jnd-cz/kids-timer/production/bom.csv

Designator | Footprint | Quantity | Value | LCSC Part #
BZ1 | Buzzer_HNDZ_MLT-8530_8.5x8.5mm | 1 | MLT-8530 | C94599
C1 | 0805 | 1 | 4.7uF | C1779
C10, C11, C12, C13, C14, C15, C16, C17, C18, C19, C20, C30, C31, C32, C33, C36, C37, C38, C39, C41, C42, C50, C51, C61, C62, C64, C71 | 0402 | 27 | 100nF | C1525
C2, C3, C43, C5, C63, C7, C70, C8 | 0805 | 8 | 10uF | C15850
C21, C22, C23, C52 | 0402 | 4 | 4.7uF | C23733
C24, C25 | 0402 | 2 | 33pF | C1562
C34, C40, C44 | 0805 | 3 | 22uF | C45783
C4, C6, C9 | 0603 | 3 | 100nF | C14663
C60 | 0402 | 1 | 4.7nF | C1538
D1 | 0603 | 1 | CHG | C2286
D100, D101, D102, D103, D104, D105, D106, D107, D108, D109, D110, D111, D112, D113, D114, D115, D116, D117, D118, D119, D120, D121, D122, D123, D124, D125, D126, D127, D128, D129, D130, D131, D132, D133, D134, D135, D136, D137, D138, D139, D140, D141, D142, D143, D144, D145, D146, D147, D148, D149, D150, D151, D152, D153, D154, D155, D156, D157, D158, D159 | 0805 | 60 | GREEN | C2297
D160, D161, D162, D163 | 0805 | 4 | YELLOW | C2296
D200, D201, D202, D203, D204, D205, D206, D207, D208, D209, D210, D211, D212, D213, D214, D215, D216, D217, D218, D219, D220, D221, D222, D223, D224, D225, D226, D227, D228, D229, D230, D231, D232, D233, D234, D235, D236, D237, D238, D239, D240, D241, D242, D243, D244, D245, D246, D247, D248, D249, D250, D251, D252, D253, D254, D255, D256, D257, D258, D259 | 0805 | 60 | RED | C84256
D300, D301 | 0805 | 2 | WHITE | C34499
DS1, DS2, DS3, DS4 | GS8011_SMD_16.8x28mm | 4 | GS8011AW-G | C22462707
J1 | USB_C_Receptacle_HRO_TYPE-C-31-M-12 | 1 | USB-C | C165948
J2 | JST_PH_S2B-PH-SM4-TB_1x02-1MP_P2.00mm_Horizontal | 1 | LiPo JST-PH | C295747
J4 | JST_PH_S2B-PH-SM4-TB_1x02-1MP_P2.00mm_Horizontal | 1 | SPEAKER | C295747
L1 | 1008 | 1 | 1.5uH | C98349
L2 | L_Changjiang_FTC201612S | 1 | 3.3uH | C41405891
Q1, Q4 | SOT-23 | 2 | AO3401A | C15127
Q2 | SOT-23-6 | 1 | HJ8205 | C20069150
Q3, Q5 | SOT-23 | 2 | 2N7002 | C8545
R1, R2 | 0603 | 2 | 5.1k | C23186
R10, R6, R7, R8 | 0603 | 4 | 100k | C25803
R11 | 0603 | 1 | 100 | C22775
R12, R3 | 0603 | 2 | 1k | C21190
R13 | 0603 | 1 | 1M | C22935
R14, R15 | 0603 | 2 | 220k | C22961
R16, R22, R73 | 0402 | 3 | 33 | C25105
R17, R20 | 0402 | 2 | 1k | C11702
R18, R19 | 0603 | 2 | 27 | C25190
R21, R50, R72 | 0402 | 3 | 10k | C25744
R30, R31, R32, R33, R34, R35, R36, R37 | 0402 | 8 | 3.3k | C25890
R38, R39 | 0402 | 2 | 2k | C4109
R4 | 0603 | 1 | 1.2k | C22765
R40, R41, R63, R70 | 0402 | 4 | 100k | C25741
R5 | 0603 | 1 | 10k | C25804
R51, R52, R60 | 0402 | 3 | 4.7k | C25900
R53, R54 | 0402 | 2 | 1M | C26083
R61, R62 | 0402 | 2 | 47k | C25792
R71 | 0402 | 1 | 470 | C25117
R9 | 0603 | 1 | 1.5k | C22843
SW1 | SW_SPDT_MSK12C02_EdgeNotch | 1 | MSK12C02 | C22435661
SW2 | SW_SPST_XUNPU_TS-1088_3.9x3mm | 1 | BOOTSEL | C720477
SW3 | SW_SPST_XUNPU_TS-1088_3.9x3mm | 1 | RESET | C720477
SW4 | SW_SPST_XUNPU_TS-1088_3.9x3mm | 1 | BTN1 | C720477
SW5 | SW_SPST_XUNPU_TS-1088_3.9x3mm | 1 | BTN2 | C720477
SW6 | SW_SPST_XUNPU_TS-1088_3.9x3mm | 1 | BTN3 | C720477
SW7 | SW_SPST_XUNPU_TS-1088_3.9x3mm | 1 | BTN4 | C720477
SW8 | SW_SPST_XUNPU_TS-1088_3.9x3mm | 1 | BTN5 | C720477
U1 | SOT-23-6 | 1 | SRV05-4 | C85364
U10, U11, U12, U13, U14, U15, U16, U17, U18, U19 | QSOP-24_3.9x8.7mm_P0.635mm | 10 | SM16206S | C121618
U2 | VQFN-16-1EP_3x3mm_P0.5mm_EP1.6x1.6mm | 1 | BQ24073RGT | C15220
U3 | SOT-23-6 | 1 | DW01A | C42380662
U4 | WSON-10-1EP_2.5x2.5mm_P0.5mm_EP1.2x2mm | 1 | TPS63031DSK | C15516
U5 | QFN-60-1EP_7x7mm_P0.4mm_EP3.4x3.4mm | 1 | RP2354A | C41378174
U6 | Vishay_VEML6030_2x2mm | 1 | VEML6030 | C132182
U7 | LGA-12_2x2mm_P0.5mm | 1 | STK8328-C | C49230199
U8 | RaspberryPi_RM2_14.5x16.5mm | 1 | RMC20452T | C49451547
U9 | MSOP-8_3x3mm_P0.65mm | 1 | PAM8302AAS | C113367
Y1 | Crystal_SMD_3225-4Pin_3.2x2.5mm | 1 | 12MHz 20pF | C9002
