jnd-cz/kids-timer/kids-timer.kicad_pcb

## KiCad design kids-timer.kicad_pcb (2026-10-30)

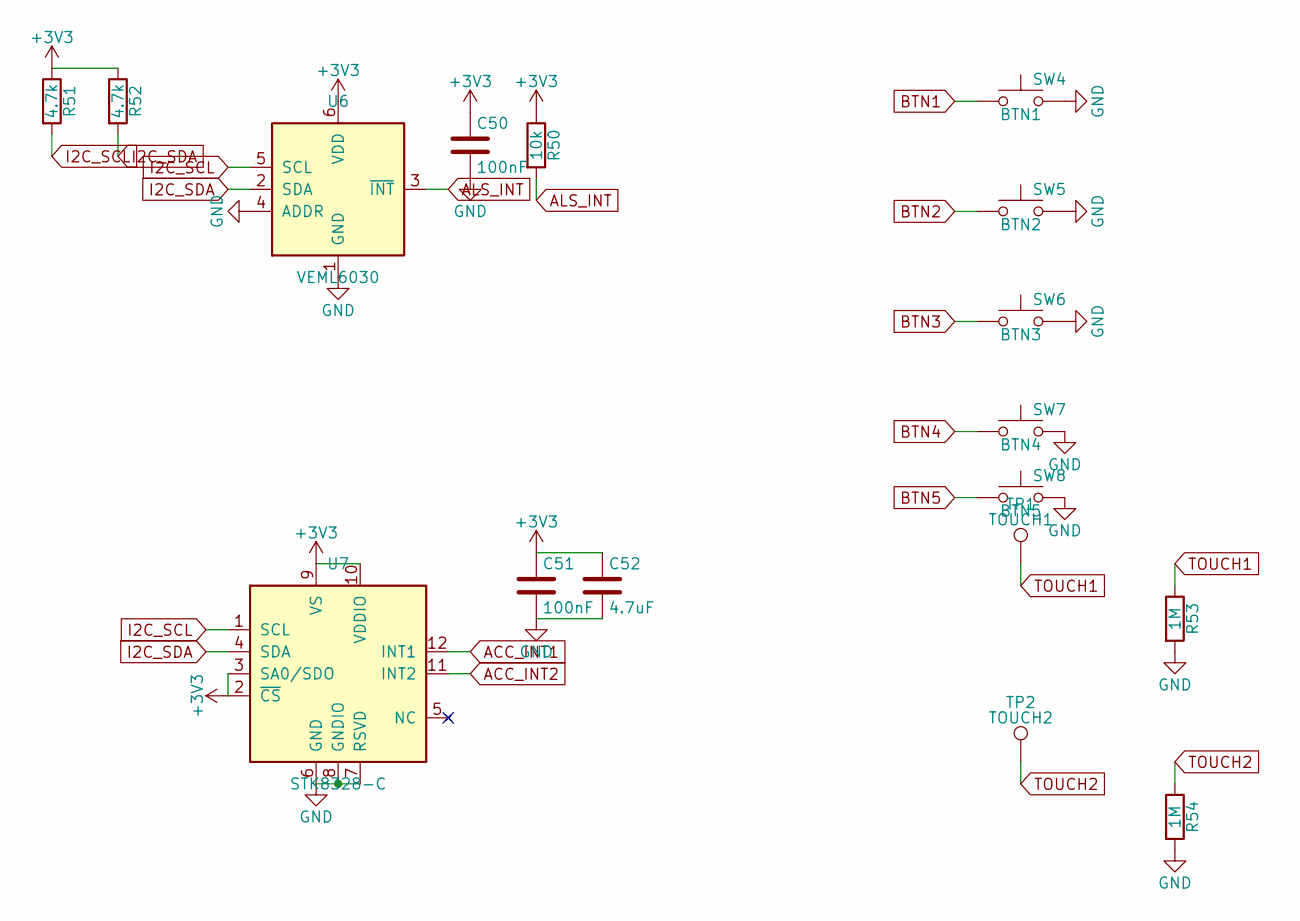
[picture p1: schematic sensors.kicad_sch]

Parts:
C50, C51: 100nF; C_0402_1005Metric; LCSC C1525
C52: 4.7uF; C_0402_1005Metric; LCSC C23733
R50: 10k; R_0402_1005Metric; LCSC C25744
R51, R52: 4.7k; R_0402_1005Metric; LCSC C25900
R53, R54: 1M; R_0402_1005Metric; LCSC C26083
SW4: BTN1; SW_SPST_XUNPU_TS-1088_3.9x3mm; MPN TS-1088-AR02016; LCSC C720477
SW5: BTN2; SW_SPST_XUNPU_TS-1088_3.9x3mm; MPN TS-1088-AR02016; LCSC C720477
SW6: BTN3; SW_SPST_XUNPU_TS-1088_3.9x3mm; MPN TS-1088-AR02016; LCSC C720477
SW7: BTN4; SW_SPST_XUNPU_TS-1088_3.9x3mm; MPN TS-1088-AR02016; LCSC C720477
SW8: BTN5; SW_SPST_XUNPU_TS-1088_3.9x3mm; MPN TS-1088-AR02016; LCSC C720477
TP1: TOUCH1; TouchPad_D12mm
TP2: TOUCH2; TouchPad_D12mm
U6: VEML6030; Vishay_VEML6030_2x2mm; MPN VEML6030; LCSC C132182
U7: STK8328-C; LGA-12_2x2mm_P0.5mm; MPN STK8328-C; LCSC C49230199

Connections:
+3V3: C50.1, C51.1, C52.1, R50.1, R51.1, R52.1, U6.6 (VDD), U7.2 (~CS), U7.3 (SA0/SDO), U7.9 (VS), U7.10 (VDDIO); also elsewhere on the board
ACC_INT1: U7.12 (INT1); also elsewhere on the board
ACC_INT2: U7.11 (INT2); also elsewhere on the board
ALS_INT: R50.2, U6.3 (~INT); also elsewhere on the board
BTN1: SW4.1; also elsewhere on the board
BTN2: SW5.1; also elsewhere on the board
BTN3: SW6.1; also elsewhere on the board
BTN4: SW7.1; also elsewhere on the board
BTN5: SW8.1; also elsewhere on the board
I2C_SCL: R51.2, U6.5 (SCL), U7.1 (SCL); also elsewhere on the board
I2C_SDA: R52.2, U6.2 (SDA), U7.4 (SDA); also elsewhere on the board
TOUCH1: R53.1, TP1.1 (1_1); also elsewhere on the board
TOUCH2: R54.1, TP2.1 (1_1); also elsewhere on the board

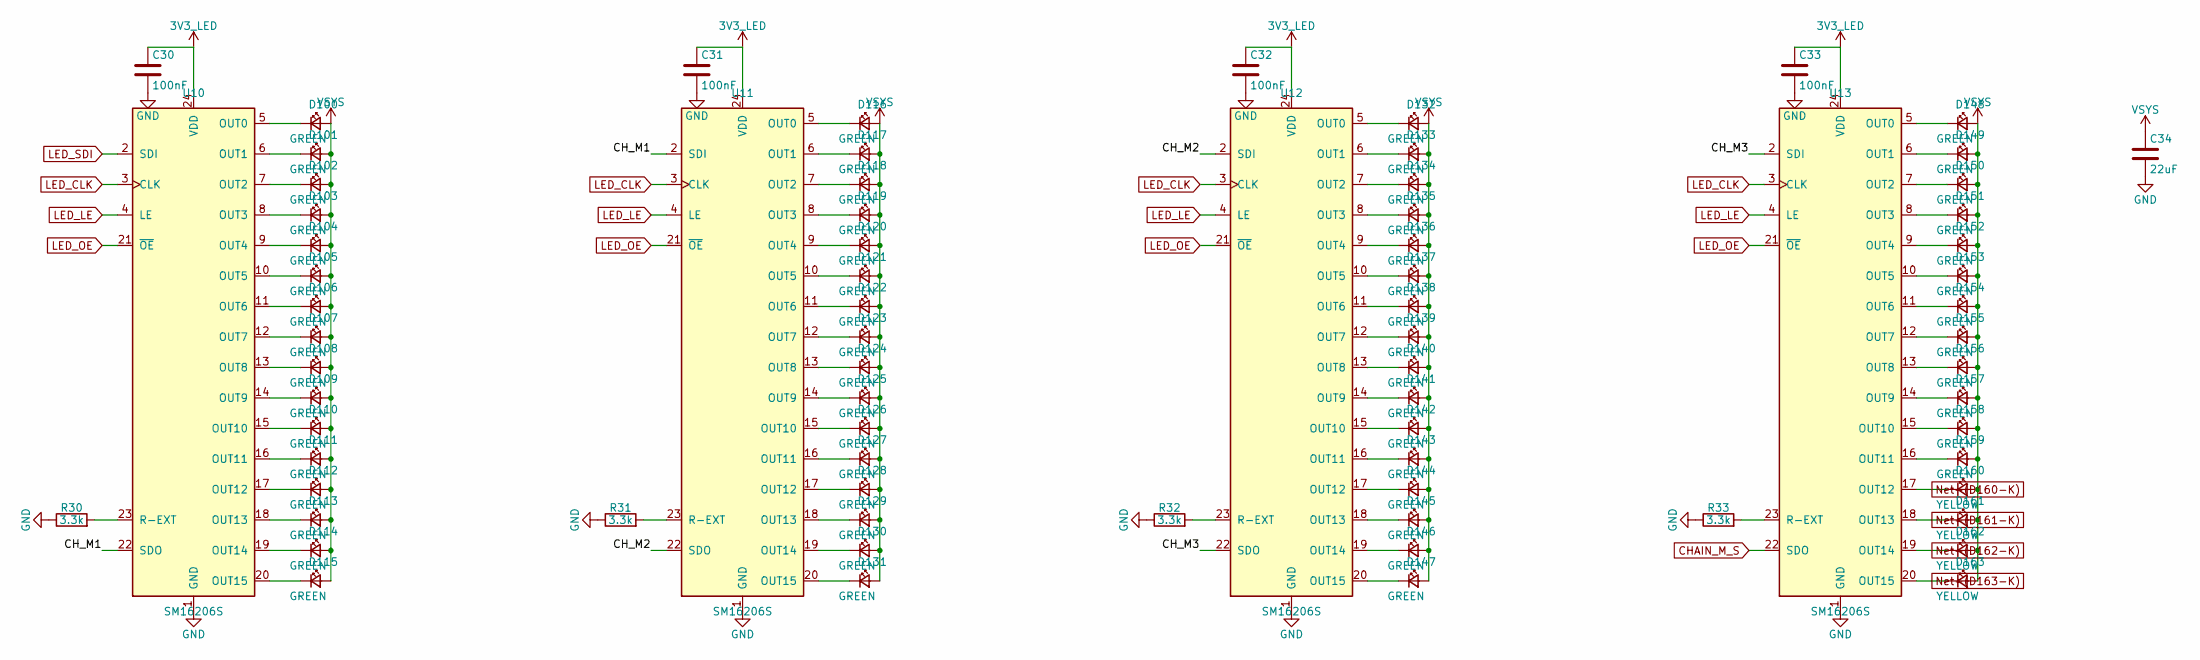
[picture p2: schematic minutes.kicad_sch]

Parts:
C30, C31, C32, C33: 100nF; C_0402_1005Metric; LCSC C1525
C34: 22uF; C_0805_2012Metric; LCSC C45783
D100, D101, D102, D103, D104, D105, D106, D107, D108, D109, D110, D111, D112, D113, D114, D115, D116, D117, D118, D119, D120, D121, D122, D123, D124, D125, D126, D127, D128, D129, D130, D131, D132, D133, D134, D135, D136, D137, D138, D139, D140, D141, D142, D143, D144, D145, D146, D147, D148, D149, D150, D151, D152, D153, D154, D155, D156, D157, D158, D159: GREEN; LED_0805_2012Metric_Ring; MPN KT-0805G; LCSC C2297
D160, D161, D162, D163: YELLOW; LED_0805_2012Metric; MPN KT-0805Y; LCSC C2296
R30, R31, R32, R33: 3.3k; R_0402_1005Metric; LCSC C25890
U10, U11, U12, U13: SM16206S; QSOP-24_3.9x8.7mm_P0.635mm; MPN SM16206S; LCSC C121618

Connections:
3V3_LED: C30.1, C31.1, C32.1, C33.1, U10.24 (VDD), U11.24 (VDD), U12.24 (VDD), U13.24 (VDD); also elsewhere on the board
/Minutes ring/CH_M1: U10.22 (SDO), U11.2 (SDI)
/Minutes ring/CH_M2: U11.22 (SDO), U12.2 (SDI)
/Minutes ring/CH_M3: U12.22 (SDO), U13.2 (SDI)
CHAIN_M_S: U13.22 (SDO); also elsewhere on the board
LED_CLK: U10.3 (CLK), U11.3 (CLK), U12.3 (CLK), U13.3 (CLK); also elsewhere on the board
LED_LE: U10.4 (LE), U11.4 (LE), U12.4 (LE), U13.4 (LE); also elsewhere on the board
LED_OE: U10.21 (~OE), U11.21 (~OE), U12.21 (~OE), U13.21 (~OE); also elsewhere on the board
LED_SDI: U10.2 (SDI); also elsewhere on the board
unnamed: D100.1 (K), U10.5 (OUT0)
unnamed: D101.1 (K), U10.6 (OUT1)
unnamed: D102.1 (K), U10.7 (OUT2)
unnamed: D103.1 (K), U10.8 (OUT3)
unnamed: D104.1 (K), U10.9 (OUT4)
unnamed: D105.1 (K), U10.10 (OUT5)
unnamed: D106.1 (K), U10.11 (OUT6)
unnamed: D107.1 (K), U10.12 (OUT7)
unnamed: D108.1 (K), U10.13 (OUT8)
unnamed: D109.1 (K), U10.14 (OUT9)
unnamed: D110.1 (K), U10.15 (OUT10)
unnamed: D111.1 (K), U10.16 (OUT11)
unnamed: D112.1 (K), U10.17 (OUT12)
unnamed: D113.1 (K), U10.18 (OUT13)
unnamed: D114.1 (K), U10.19 (OUT14)
unnamed: D115.1 (K), U10.20 (OUT15)
unnamed: D116.1 (K), U11.5 (OUT0)
unnamed: D117.1 (K), U11.6 (OUT1)
unnamed: D118.1 (K), U11.7 (OUT2)
unnamed: D119.1 (K), U11.8 (OUT3)
unnamed: D120.1 (K), U11.9 (OUT4)
unnamed: D121.1 (K), U11.10 (OUT5)
unnamed: D122.1 (K), U11.11 (OUT6)
unnamed: D123.1 (K), U11.12 (OUT7)
unnamed: D124.1 (K), U11.13 (OUT8)
unnamed: D125.1 (K), U11.14 (OUT9)
unnamed: D126.1 (K), U11.15 (OUT10)
unnamed: D127.1 (K), U11.16 (OUT11)
unnamed: D128.1 (K), U11.17 (OUT12)
unnamed: D129.1 (K), U11.18 (OUT13)
unnamed: D130.1 (K), U11.19 (OUT14)
unnamed: D131.1 (K), U11.20 (OUT15)
unnamed: D132.1 (K), U12.5 (OUT0)
unnamed: D133.1 (K), U12.6 (OUT1)
unnamed: D134.1 (K), U12.7 (OUT2)
unnamed: D135.1 (K), U12.8 (OUT3)
unnamed: D136.1 (K), U12.9 (OUT4)
unnamed: D137.1 (K), U12.10 (OUT5)
unnamed: D138.1 (K), U12.11 (OUT6)
unnamed: D139.1 (K), U12.12 (OUT7)
unnamed: D140.1 (K), U12.13 (OUT8)
unnamed: D141.1 (K), U12.14 (OUT9)
unnamed: D142.1 (K), U12.15 (OUT10)
unnamed: D143.1 (K), U12.16 (OUT11)
unnamed: D144.1 (K), U12.17 (OUT12)
unnamed: D145.1 (K), U12.18 (OUT13)
unnamed: D146.1 (K), U12.19 (OUT14)
unnamed: D147.1 (K), U12.20 (OUT15)
unnamed: D148.1 (K), U13.5 (OUT0)
unnamed: D149.1 (K), U13.6 (OUT1)
unnamed: D150.1 (K), U13.7 (OUT2)
unnamed: D151.1 (K), U13.8 (OUT3)
unnamed: D152.1 (K), U13.9 (OUT4)
unnamed: D153.1 (K), U13.10 (OUT5)
unnamed: D154.1 (K), U13.11 (OUT6)
unnamed: D155.1 (K), U13.12 (OUT7)
unnamed: D156.1 (K), U13.13 (OUT8)
unnamed: D157.1 (K), U13.14 (OUT9)
unnamed: D158.1 (K), U13.15 (OUT10)
unnamed: D159.1 (K), U13.16 (OUT11)
unnamed: D160.1 (K), U13.17 (OUT12)
unnamed: D161.1 (K), U13.18 (OUT13)
unnamed: D162.1 (K), U13.19 (OUT14)
unnamed: D163.1 (K), U13.20 (OUT15)
unnamed: R30.2, U10.23 (R-EXT)
unnamed: R31.2, U11.23 (R-EXT)
unnamed: R32.2, U12.23 (R-EXT)
unnamed: R33.2, U13.23 (R-EXT)
VSYS: C34.1, D100.2 (A), D101.2 (A), D102.2 (A), D103.2 (A), D104.2 (A), D105.2 (A), D106.2 (A), D107.2 (A), D108.2 (A), D109.2 (A), D110.2 (A), D111.2 (A), D112.2 (A), D113.2 (A), D114.2 (A), D115.2 (A), D116.2 (A), D117.2 (A), D118.2 (A), D119.2 (A), D120.2 (A), D121.2 (A), D122.2 (A), D123.2 (A), D124.2 (A), D125.2 (A), D126.2 (A), D127.2 (A), D128.2 (A), D129.2 (A), D130.2 (A), D131.2 (A), D132.2 (A), D133.2 (A), D134.2 (A), D135.2 (A), D136.2 (A), D137.2 (A), D138.2 (A), D139.2 (A), D140.2 (A), D141.2 (A), D142.2 (A), D143.2 (A), D144.2 (A), D145.2 (A), D146.2 (A), D147.2 (A), D148.2 (A), D149.2 (A), D150.2 (A), D151.2 (A), D152.2 (A), D153.2 (A), D154.2 (A), D155.2 (A), D156.2 (A), D157.2 (A), D158.2 (A), D159.2 (A), D160.2 (A), D161.2 (A), D162.2 (A), D163.2 (A); also elsewhere on the board

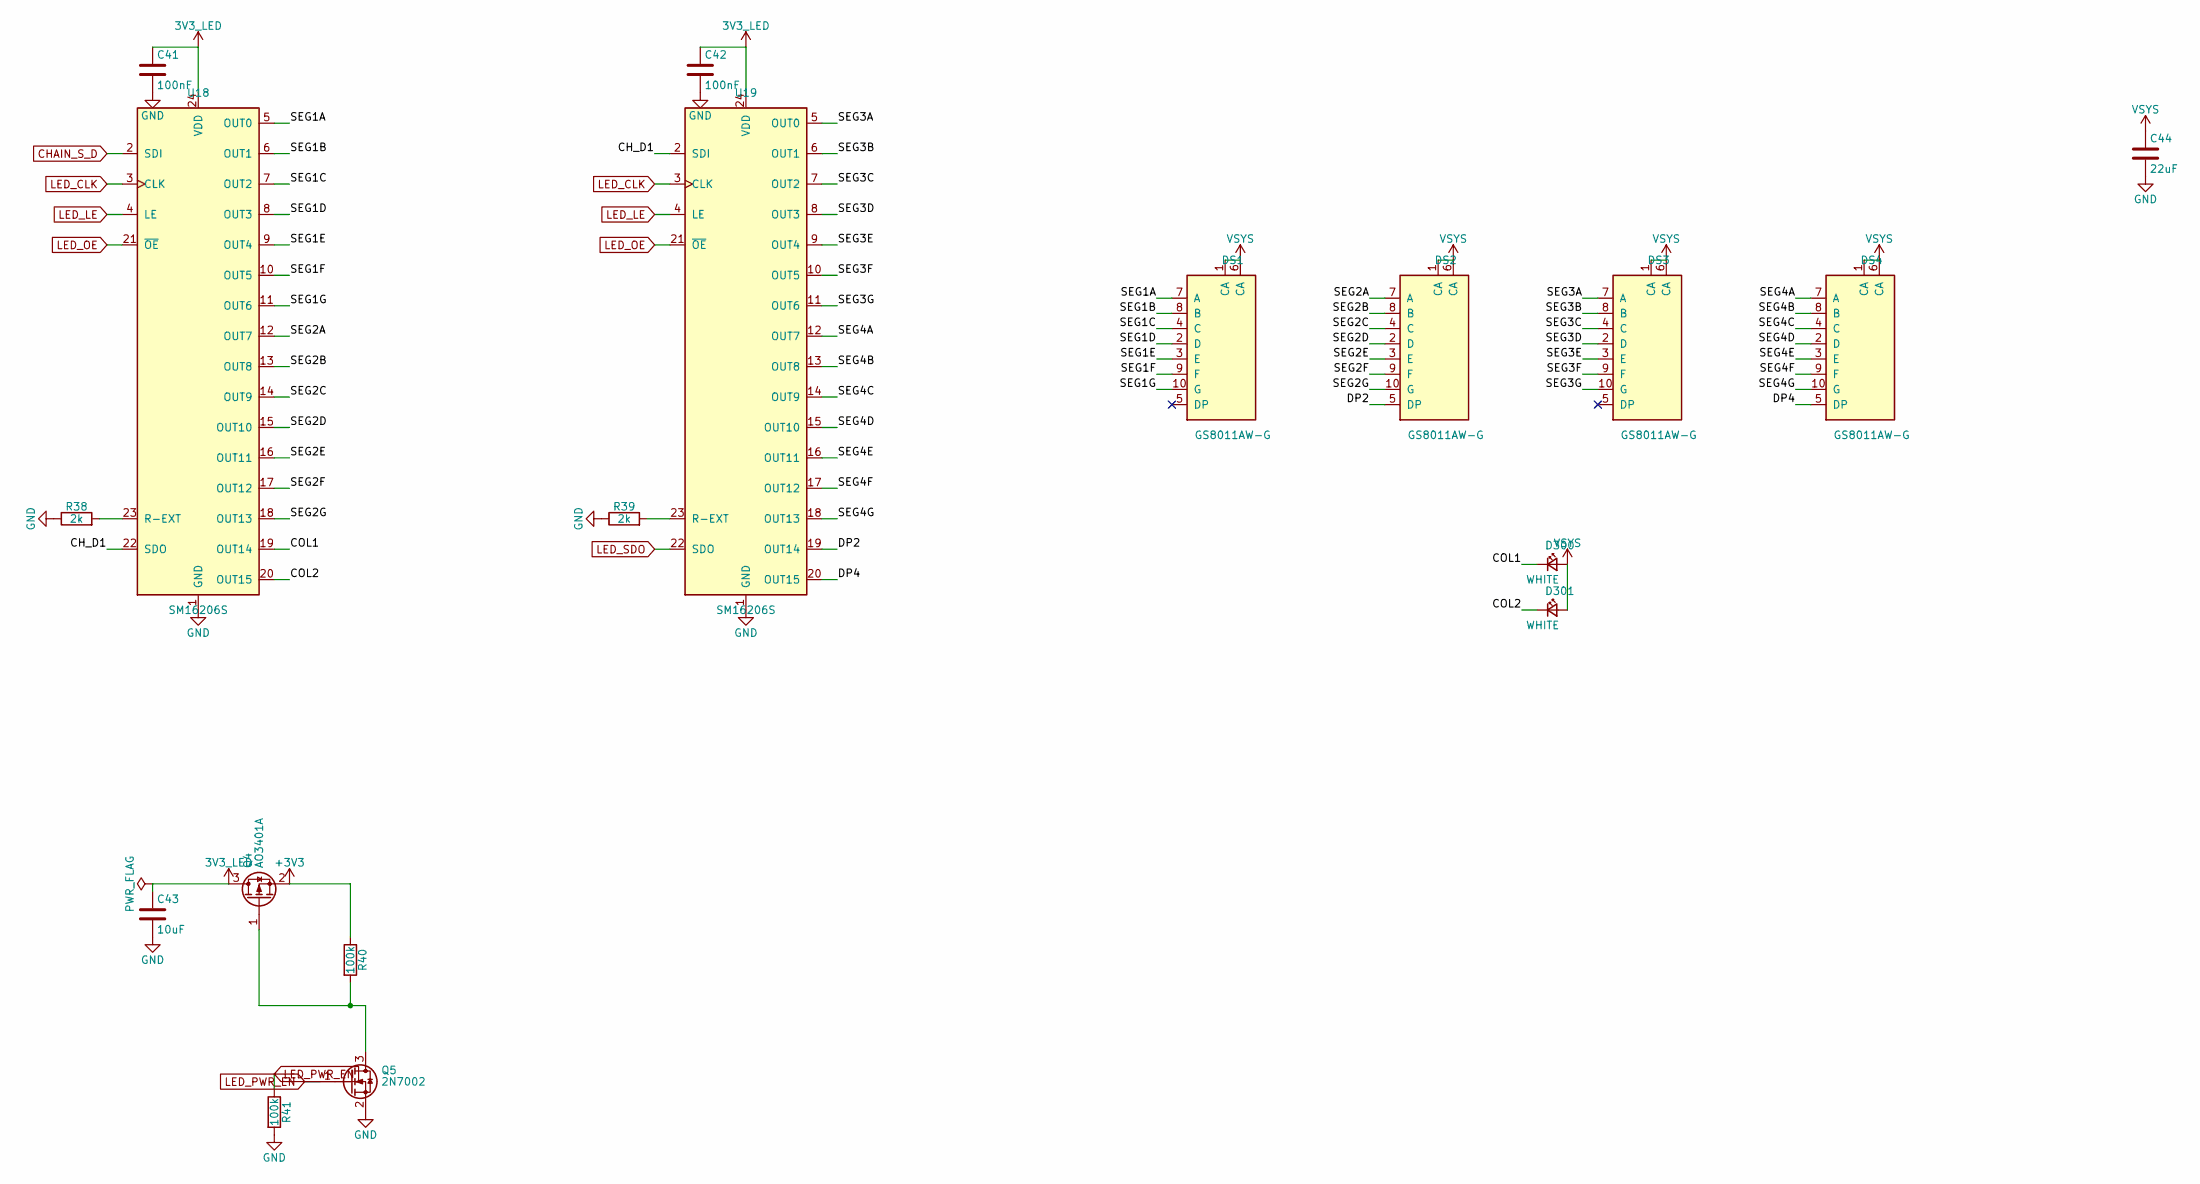
[picture p3: schematic display.kicad_sch]

Parts:
C41, C42: 100nF; C_0402_1005Metric; LCSC C1525
C43: 10uF; C_0805_2012Metric; LCSC C15850
C44: 22uF; C_0805_2012Metric; LCSC C45783
D300, D301: WHITE; LED_0805_2012Metric; LCSC C34499
DS1, DS2, DS3, DS4: GS8011AW-G; GS8011_SMD_16.8x28mm; LCSC C22462707
Q4: AO3401A; SOT-23; LCSC C15127
Q5: 2N7002; SOT-23; LCSC C8545
R38, R39: 2k; R_0402_1005Metric; LCSC C4109
R40, R41: 100k; R_0402_1005Metric; LCSC C25741
U18, U19: SM16206S; QSOP-24_3.9x8.7mm_P0.635mm; LCSC C121618

Connections:
3V3_LED: C41.1, C42.1, C43.1, Q4.3 (D), U18.24 (VDD), U19.24 (VDD); also elsewhere on the board
+3V3: Q4.2 (S), R40.1; also elsewhere on the board
/Display/CH_D1: U18.22 (SDO), U19.2 (SDI)
/Display/COL1: D300.1 (K), U18.19 (OUT14)
/Display/COL2: D301.1 (K), U18.20 (OUT15)
/Display/DP2: DS2.5 (DP), U19.19 (OUT14)
/Display/DP4: DS4.5 (DP), U19.20 (OUT15)
/Display/SEG1A: DS1.7 (A), U18.5 (OUT0)
/Display/SEG1B: DS1.8 (B), U18.6 (OUT1)
/Display/SEG1C: DS1.4 (C), U18.7 (OUT2)
/Display/SEG1D: DS1.2 (D), U18.8 (OUT3)
/Display/SEG1E: DS1.3 (E), U18.9 (OUT4)
/Display/SEG1F: DS1.9 (F), U18.10 (OUT5)
/Display/SEG1G: DS1.10 (G), U18.11 (OUT6)
/Display/SEG2A: DS2.7 (A), U18.12 (OUT7)
/Display/SEG2B: DS2.8 (B), U18.13 (OUT8)
/Display/SEG2C: DS2.4 (C), U18.14 (OUT9)
/Display/SEG2D: DS2.2 (D), U18.15 (OUT10)
/Display/SEG2E: DS2.3 (E), U18.16 (OUT11)
/Display/SEG2F: DS2.9 (F), U18.17 (OUT12)
/Display/SEG2G: DS2.10 (G), U18.18 (OUT13)
/Display/SEG3A: DS3.7 (A), U19.5 (OUT0)
/Display/SEG3B: DS3.8 (B), U19.6 (OUT1)
/Display/SEG3C: DS3.4 (C), U19.7 (OUT2)
/Display/SEG3D: DS3.2 (D), U19.8 (OUT3)
/Display/SEG3E: DS3.3 (E), U19.9 (OUT4)
/Display/SEG3F: DS3.9 (F), U19.10 (OUT5)
/Display/SEG3G: DS3.10 (G), U19.11 (OUT6)
/Display/SEG4A: DS4.7 (A), U19.12 (OUT7)
/Display/SEG4B: DS4.8 (B), U19.13 (OUT8)
/Display/SEG4C: DS4.4 (C), U19.14 (OUT9)
/Display/SEG4D: DS4.2 (D), U19.15 (OUT10)
/Display/SEG4E: DS4.3 (E), U19.16 (OUT11)
/Display/SEG4F: DS4.9 (F), U19.17 (OUT12)
/Display/SEG4G: DS4.10 (G), U19.18 (OUT13)
CHAIN_S_D: U18.2 (SDI); also elsewhere on the board
LED_CLK: U18.3 (CLK), U19.3 (CLK); also elsewhere on the board
LED_LE: U18.4 (LE), U19.4 (LE); also elsewhere on the board
LED_OE: U18.21 (~OE), U19.21 (~OE); also elsewhere on the board
LED_PWR_EN: Q5.1 (G), R41.1; also elsewhere on the board
LED_SDO: U19.22 (SDO); also elsewhere on the board
unnamed: Q4.1 (G), Q5.3 (D), R40.2
unnamed: R38.2, U18.23 (R-EXT)
unnamed: R39.2, U19.23 (R-EXT)
VSYS: C44.1, D300.2 (A), D301.2 (A), DS1.1 (CA), DS1.6 (CA), DS2.1 (CA), DS2.6 (CA), DS3.1 (CA), DS3.6 (CA), DS4.1 (CA), DS4.6 (CA); also elsewhere on the board

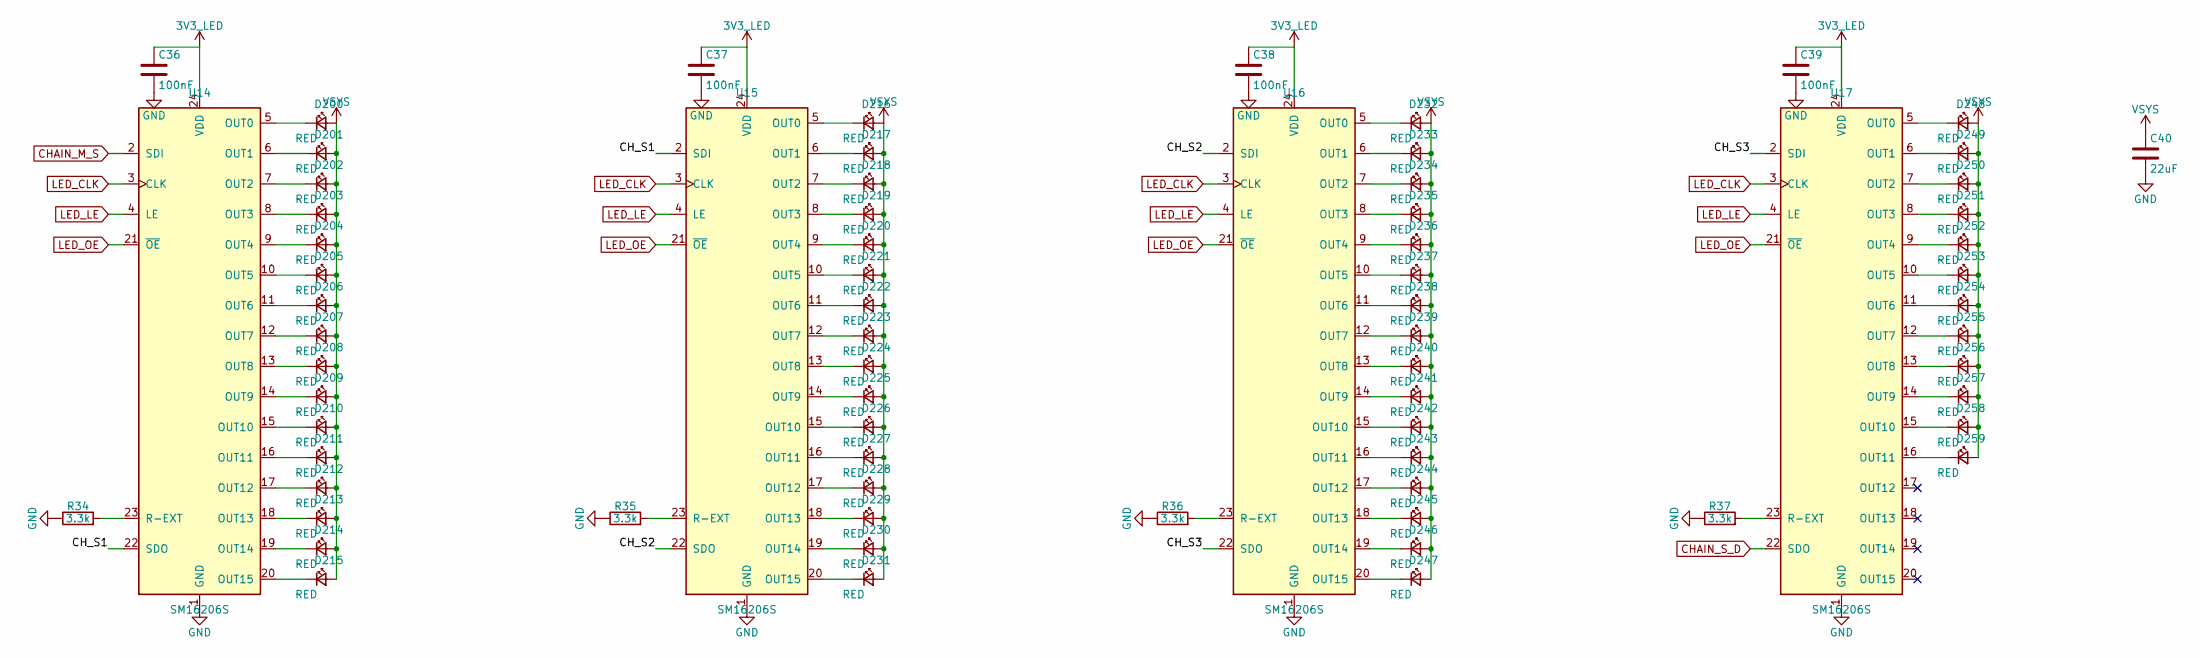
[picture p4: schematic seconds.kicad_sch]

Parts:
C36, C37, C38, C39: 100nF; C_0402_1005Metric; LCSC C1525
C40: 22uF; C_0805_2012Metric; LCSC C45783
D200, D201, D202, D203, D204, D205, D206, D207, D208, D209, D210, D211, D212, D213, D214, D215, D216, D217, D218, D219, D220, D221, D222, D223, D224, D225, D226, D227, D228, D229, D230, D231, D232, D233, D234, D235, D236, D237, D238, D239, D240, D241, D242, D243, D244, D245, D246, D247, D248, D249, D250, D251, D252, D253, D254, D255, D256, D257, D258, D259: RED; LED_0805_2012Metric_Ring; LCSC C84256
R34, R35, R36, R37: 3.3k; R_0402_1005Metric; LCSC C25890
U14, U15, U16, U17: SM16206S; QSOP-24_3.9x8.7mm_P0.635mm; LCSC C121618

Connections:
3V3_LED: C36.1, C37.1, C38.1, C39.1, U14.24 (VDD), U15.24 (VDD), U16.24 (VDD), U17.24 (VDD); also elsewhere on the board
/Seconds ring/CH_S1: U14.22 (SDO), U15.2 (SDI)
/Seconds ring/CH_S2: U15.22 (SDO), U16.2 (SDI)
/Seconds ring/CH_S3: U16.22 (SDO), U17.2 (SDI)
CHAIN_M_S: U14.2 (SDI); also elsewhere on the board
CHAIN_S_D: U17.22 (SDO); also elsewhere on the board
LED_CLK: U14.3 (CLK), U15.3 (CLK), U16.3 (CLK), U17.3 (CLK); also elsewhere on the board
LED_LE: U14.4 (LE), U15.4 (LE), U16.4 (LE), U17.4 (LE); also elsewhere on the board
LED_OE: U14.21 (~OE), U15.21 (~OE), U16.21 (~OE), U17.21 (~OE); also elsewhere on the board
unnamed: D200.1 (K), U14.5 (OUT0)
unnamed: D201.1 (K), U14.6 (OUT1)
unnamed: D202.1 (K), U14.7 (OUT2)
unnamed: D203.1 (K), U14.8 (OUT3)
unnamed: D204.1 (K), U14.9 (OUT4)
unnamed: D205.1 (K), U14.10 (OUT5)
unnamed: D206.1 (K), U14.11 (OUT6)
unnamed: D207.1 (K), U14.12 (OUT7)
unnamed: D208.1 (K), U14.13 (OUT8)
unnamed: D209.1 (K), U14.14 (OUT9)
unnamed: D210.1 (K), U14.15 (OUT10)
unnamed: D211.1 (K), U14.16 (OUT11)
unnamed: D212.1 (K), U14.17 (OUT12)
unnamed: D213.1 (K), U14.18 (OUT13)
unnamed: D214.1 (K), U14.19 (OUT14)
unnamed: D215.1 (K), U14.20 (OUT15)
unnamed: D216.1 (K), U15.5 (OUT0)
unnamed: D217.1 (K), U15.6 (OUT1)
unnamed: D218.1 (K), U15.7 (OUT2)
unnamed: D219.1 (K), U15.8 (OUT3)
unnamed: D220.1 (K), U15.9 (OUT4)
unnamed: D221.1 (K), U15.10 (OUT5)
unnamed: D222.1 (K), U15.11 (OUT6)
unnamed: D223.1 (K), U15.12 (OUT7)
unnamed: D224.1 (K), U15.13 (OUT8)
unnamed: D225.1 (K), U15.14 (OUT9)
unnamed: D226.1 (K), U15.15 (OUT10)
unnamed: D227.1 (K), U15.16 (OUT11)
unnamed: D228.1 (K), U15.17 (OUT12)
unnamed: D229.1 (K), U15.18 (OUT13)
unnamed: D230.1 (K), U15.19 (OUT14)
unnamed: D231.1 (K), U15.20 (OUT15)
unnamed: D232.1 (K), U16.5 (OUT0)
unnamed: D233.1 (K), U16.6 (OUT1)
unnamed: D234.1 (K), U16.7 (OUT2)
unnamed: D235.1 (K), U16.8 (OUT3)
unnamed: D236.1 (K), U16.9 (OUT4)
unnamed: D237.1 (K), U16.10 (OUT5)
unnamed: D238.1 (K), U16.11 (OUT6)
unnamed: D239.1 (K), U16.12 (OUT7)
unnamed: D240.1 (K), U16.13 (OUT8)
unnamed: D241.1 (K), U16.14 (OUT9)
unnamed: D242.1 (K), U16.15 (OUT10)
unnamed: D243.1 (K), U16.16 (OUT11)
unnamed: D244.1 (K), U16.17 (OUT12)
unnamed: D245.1 (K), U16.18 (OUT13)
unnamed: D246.1 (K), U16.19 (OUT14)
unnamed: D247.1 (K), U16.20 (OUT15)
unnamed: D248.1 (K), U17.5 (OUT0)
unnamed: D249.1 (K), U17.6 (OUT1)
unnamed: D250.1 (K), U17.7 (OUT2)
unnamed: D251.1 (K), U17.8 (OUT3)
unnamed: D252.1 (K), U17.9 (OUT4)
unnamed: D253.1 (K), U17.10 (OUT5)
unnamed: D254.1 (K), U17.11 (OUT6)
unnamed: D255.1 (K), U17.12 (OUT7)
unnamed: D256.1 (K), U17.13 (OUT8)
unnamed: D257.1 (K), U17.14 (OUT9)
unnamed: D258.1 (K), U17.15 (OUT10)
unnamed: D259.1 (K), U17.16 (OUT11)
unnamed: R34.2, U14.23 (R-EXT)
unnamed: R35.2, U15.23 (R-EXT)
unnamed: R36.2, U16.23 (R-EXT)
unnamed: R37.2, U17.23 (R-EXT)
VSYS: C40.1, D200.2 (A), D201.2 (A), D202.2 (A), D203.2 (A), D204.2 (A), D205.2 (A), D206.2 (A), D207.2 (A), D208.2 (A), D209.2 (A), D210.2 (A), D211.2 (A), D212.2 (A), D213.2 (A), D214.2 (A), D215.2 (A), D216.2 (A), D217.2 (A), D218.2 (A), D219.2 (A), D220.2 (A), D221.2 (A), D222.2 (A), D223.2 (A), D224.2 (A), D225.2 (A), D226.2 (A), D227.2 (A), D228.2 (A), D229.2 (A), D230.2 (A), D231.2 (A), D232.2 (A), D233.2 (A), D234.2 (A), D235.2 (A), D236.2 (A), D237.2 (A), D238.2 (A), D239.2 (A), D240.2 (A), D241.2 (A), D242.2 (A), D243.2 (A), D244.2 (A), D245.2 (A), D246.2 (A), D247.2 (A), D248.2 (A), D249.2 (A), D250.2 (A), D251.2 (A), D252.2 (A), D253.2 (A), D254.2 (A), D255.2 (A), D256.2 (A), D257.2 (A), D258.2 (A), D259.2 (A); also elsewhere on the board

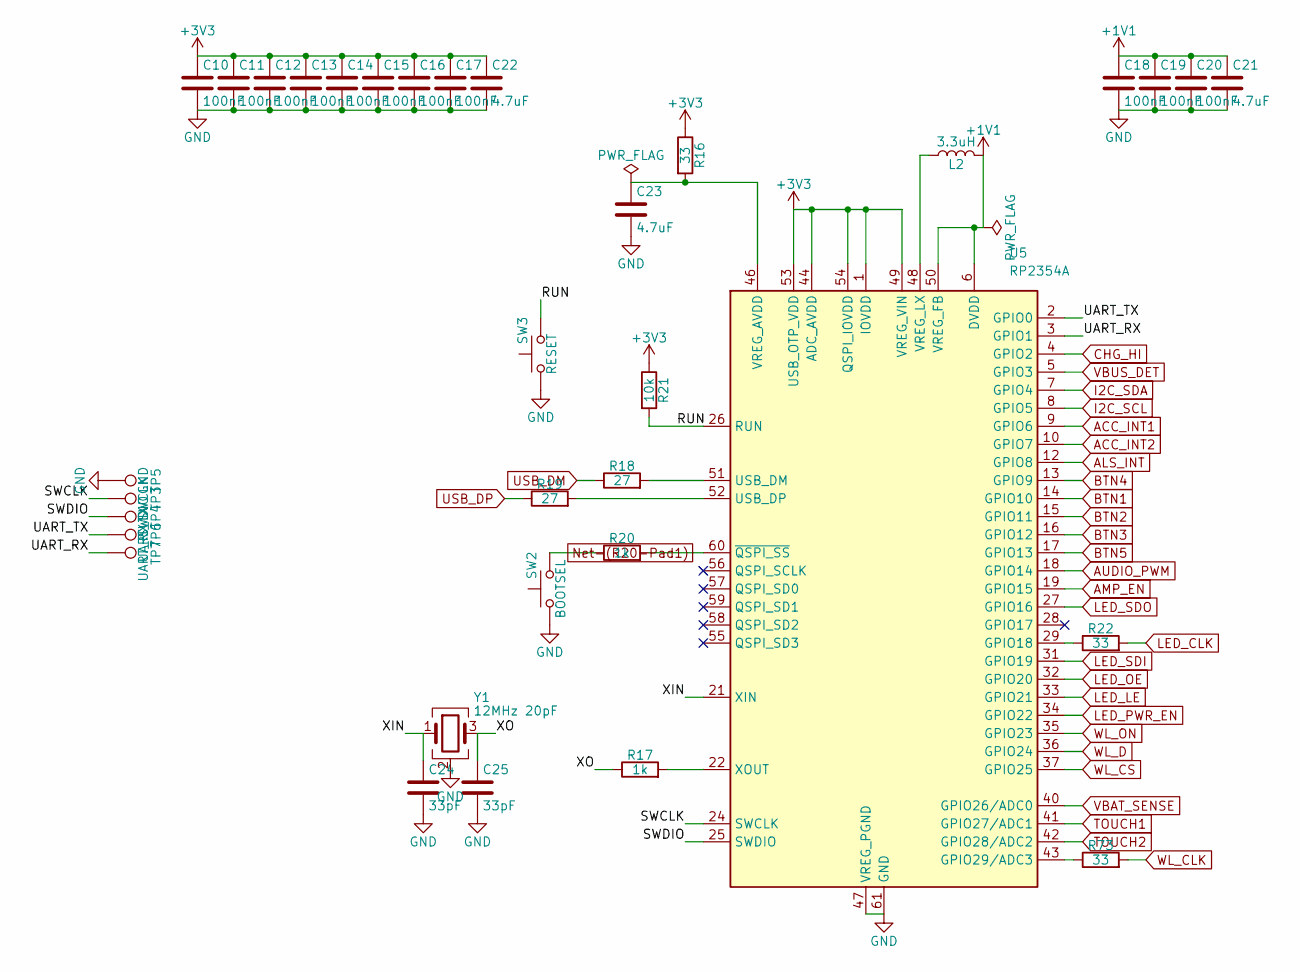
[picture p5: schematic mcu.kicad_sch]

Parts:
C10, C11, C12, C13, C14, C15, C16, C17, C18, C19, C20: 100nF; C_0402_1005Metric; LCSC C1525
C21, C22, C23: 4.7uF; C_0402_1005Metric; LCSC C23733
C24, C25: 33pF; C_0402_1005Metric; MPN 0402CG330J500NT; LCSC C1562
L2: 3.3uH; L_Changjiang_FTC201612S; MPN YSMC201612H-3R3MB; LCSC C41405891
R16, R22, R73: 33; R_0402_1005Metric; LCSC C25105
R17, R20: 1k; R_0402_1005Metric; LCSC C11702
R18, R19: 27; R_0603_1608Metric; LCSC C25190
R21: 10k; R_0402_1005Metric; LCSC C25744
SW2: BOOTSEL; SW_SPST_XUNPU_TS-1088_3.9x3mm; MPN TS-1088-AR02016; LCSC C720477
SW3: RESET; SW_SPST_XUNPU_TS-1088_3.9x3mm; MPN TS-1088-AR02016; LCSC C720477
TP3: SWCLK; TestPoint_Pad_D1.5mm
TP4: SWDIO; TestPoint_Pad_D1.5mm
TP5: GND; TestPoint_Pad_D1.5mm
TP6: UART_TX; TestPoint_Pad_D1.5mm
TP7: UART_RX; TestPoint_Pad_D1.5mm
U5: RP2354A; QFN-60-1EP_7x7mm_P0.4mm_EP3.4x3.4mm; MPN RP2354A; LCSC C41378174
Y1: 12MHz 20pF; Crystal_SMD_3225-4Pin_3.2x2.5mm; MPN X322512MSB4SI; LCSC C9002

Connections:
+3V3: C10.1, C11.1, C12.1, C13.1, C14.1, C15.1, C16.1, C17.1, C22.1, R16.1, R21.1, U5.1 (IOVDD), U5.11 (IOVDD), U5.20 (IOVDD), U5.30 (IOVDD), U5.38 (IOVDD), U5.44 (ADC_AVDD), U5.45 (IOVDD), U5.49 (VREG_VIN), U5.53 (USB_OTP_VDD), U5.54 (QSPI_IOVDD); also elsewhere on the board
/MCU/RUN: R21.2, SW3.2, U5.26 (RUN)
/MCU/SWCLK: TP3.1 (1_1), U5.24 (SWCLK)
/MCU/SWDIO: TP4.1 (1_1), U5.25 (SWDIO)
/MCU/UART_RX: TP7.1 (1_1), U5.3 (GPIO1)
/MCU/UART_TX: TP6.1 (1_1), U5.2 (GPIO0)
/MCU/XIN: C24.1, U5.21 (XIN), Y1.1
/MCU/XO: C25.1, R17.1, Y1.3
ACC_INT1: U5.9 (GPIO6); also elsewhere on the board
ACC_INT2: U5.10 (GPIO7); also elsewhere on the board
ALS_INT: U5.12 (GPIO8); also elsewhere on the board
AMP_EN: U5.19 (GPIO15); also elsewhere on the board
AUDIO_PWM: U5.18 (GPIO14); also elsewhere on the board
BTN1: U5.14 (GPIO10); also elsewhere on the board
BTN2: U5.15 (GPIO11); also elsewhere on the board
BTN3: U5.16 (GPIO12); also elsewhere on the board
BTN4: U5.13 (GPIO9); also elsewhere on the board
BTN5: U5.17 (GPIO13); also elsewhere on the board
CHG_HI: U5.4 (GPIO2); also elsewhere on the board
I2C_SCL: U5.8 (GPIO5); also elsewhere on the board
I2C_SDA: U5.7 (GPIO4); also elsewhere on the board
LED_CLK: R22.2; also elsewhere on the board
LED_LE: U5.33 (GPIO21); also elsewhere on the board
LED_OE: U5.32 (GPIO20); also elsewhere on the board
LED_PWR_EN: U5.34 (GPIO22); also elsewhere on the board
LED_SDI: U5.31 (GPIO19); also elsewhere on the board
LED_SDO: U5.27 (GPIO16); also elsewhere on the board
unnamed: R20.1, SW2.2
unnamed: R22.1, U5.29 (GPIO18)
unnamed: R73.1, U5.43 (GPIO29/ADC3)
unnamed: R18.2, U5.51 (USB_DM)
unnamed: R19.2, U5.52 (USB_DP)
unnamed: L2.1, U5.48 (VREG_LX)
unnamed: R17.2, U5.22 (XOUT)
unnamed: R20.2, U5.60 (~QSPI_SS)
TOUCH1: U5.41 (GPIO27/ADC1); also elsewhere on the board
TOUCH2: U5.42 (GPIO28/ADC2); also elsewhere on the board
USB_DM: R18.1; also elsewhere on the board
USB_DP: R19.1; also elsewhere on the board
VBAT_SENSE: U5.40 (GPIO26/ADC0); also elsewhere on the board
VBUS_DET: U5.5 (GPIO3); also elsewhere on the board
WL_CLK: R73.2; also elsewhere on the board
WL_CS: U5.37 (GPIO25); also elsewhere on the board
WL_D: U5.36 (GPIO24); also elsewhere on the board
WL_ON: U5.35 (GPIO23); also elsewhere on the board

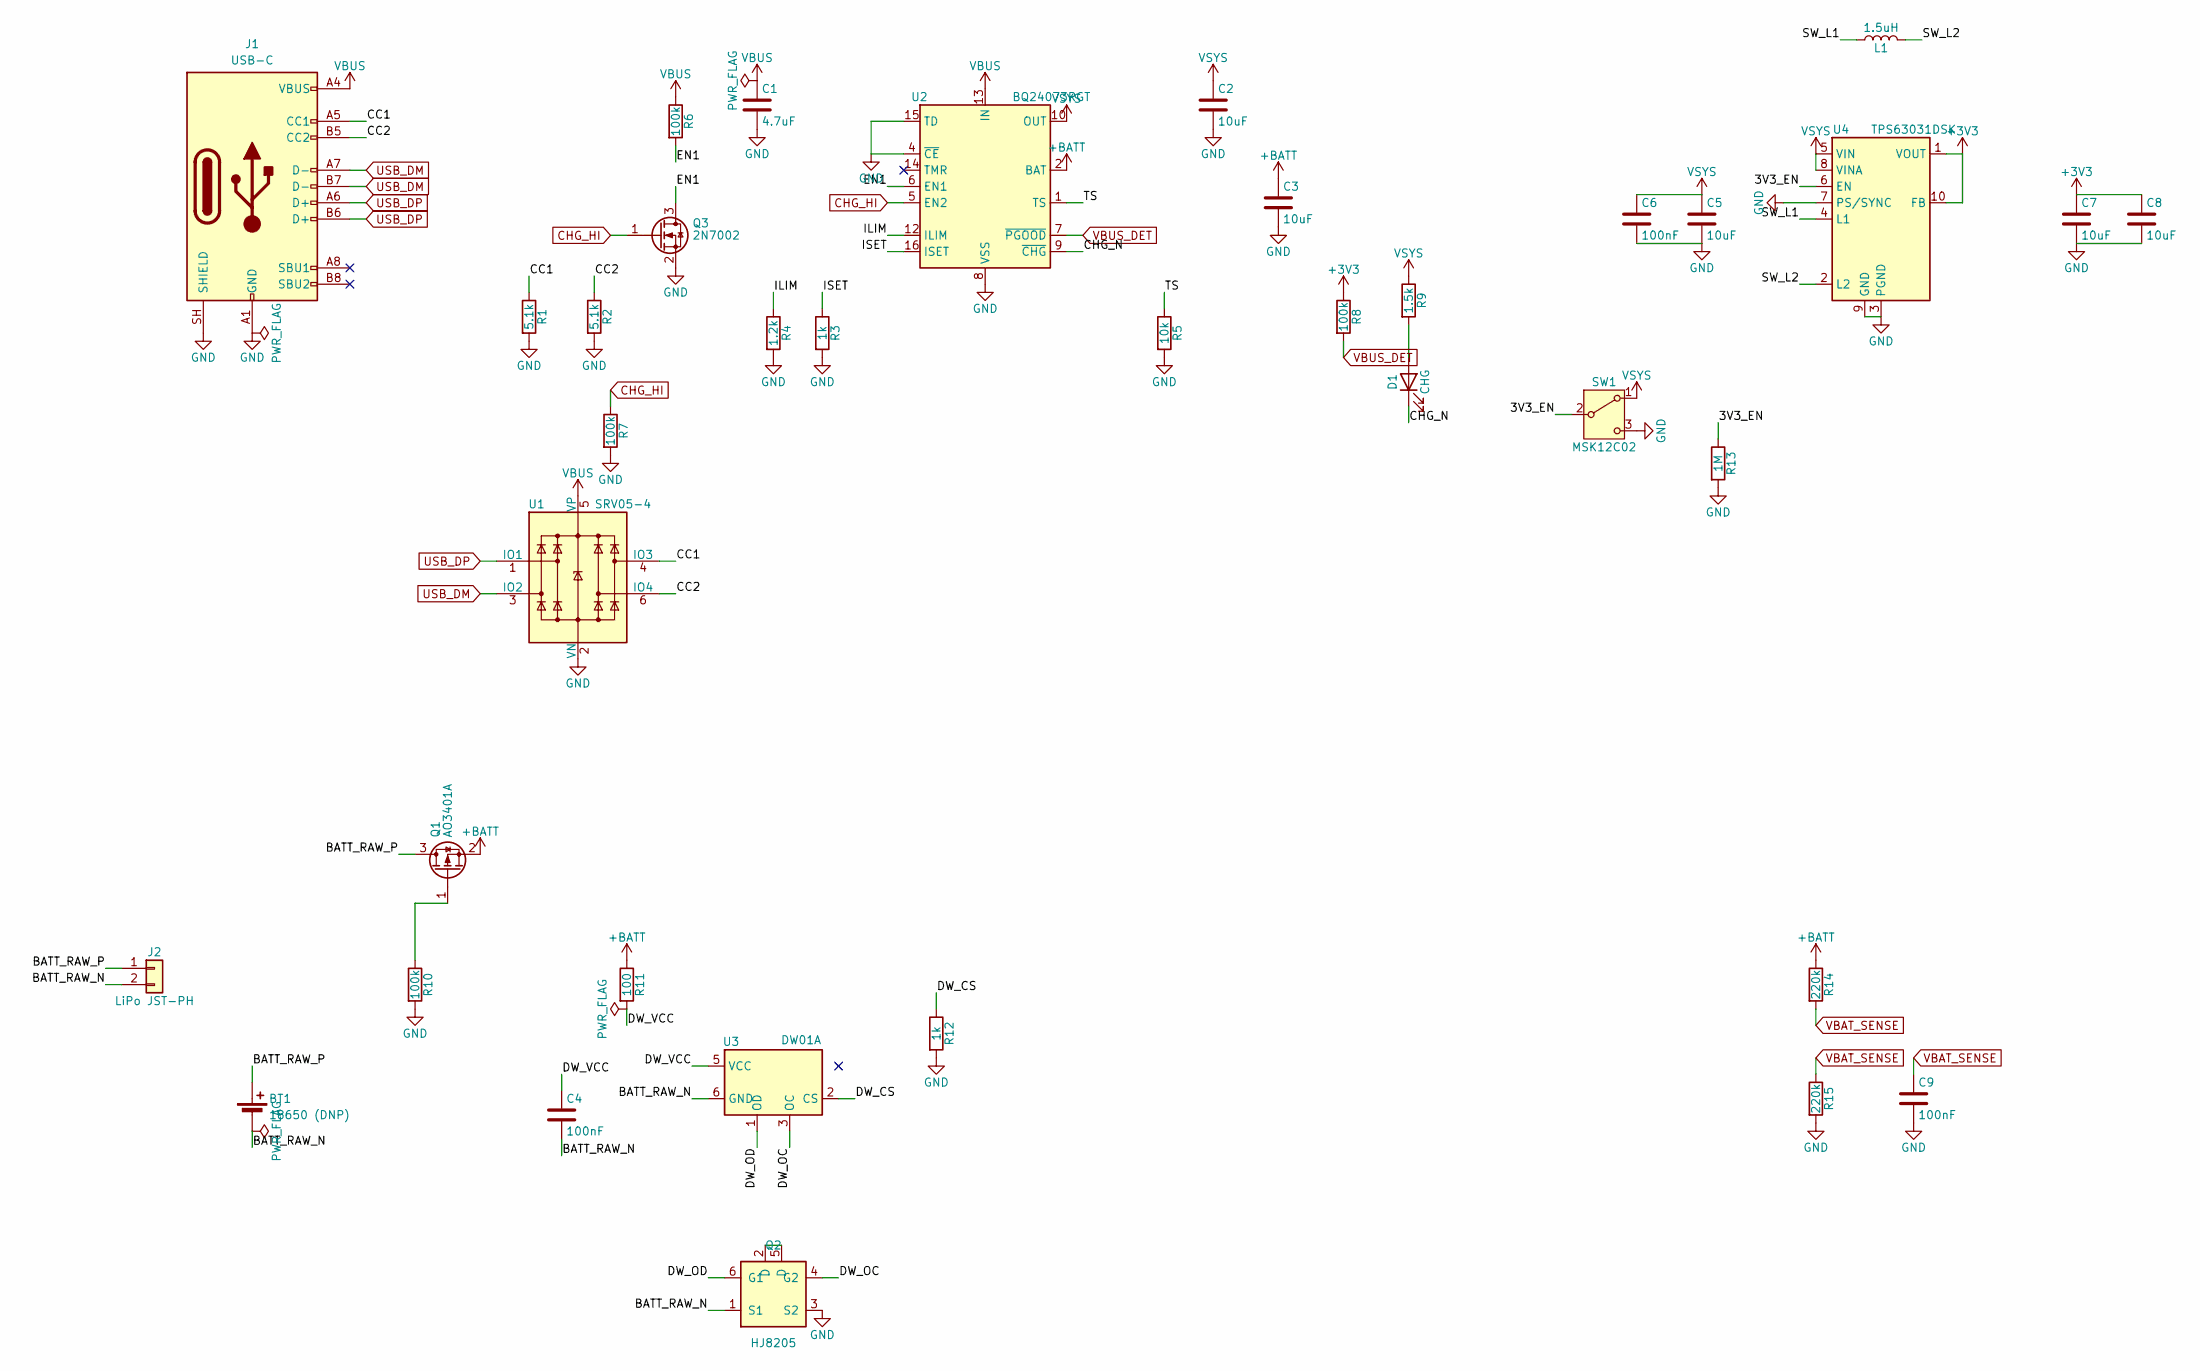
[picture p6: schematic power.kicad_sch]

Parts:
BT1: 18650 (DNP)
C1: 4.7uF; C_0805_2012Metric; LCSC C1779
C2, C3, C5, C7, C8: 10uF; C_0805_2012Metric; LCSC C15850
C4, C6, C9: 100nF; C_0603_1608Metric; LCSC C14663
D1: CHG; LED_0603_1608Metric; MPN KT-0603R; LCSC C2286
J1: USB-C; USB_C_Receptacle_HRO_TYPE-C-31-M-12; MPN TYPE-C-31-M-12; LCSC C165948
J2: LiPo JST-PH; JST_PH_S2B-PH-SM4-TB_1x02-1MP_P2.00mm_Horizontal; MPN S2B-PH-SM4-TB(LF)(SN); LCSC C295747
L1: 1.5uH; L_1008_2520Metric; MPN WPN252012H1R5MT; LCSC C98349
Q1: AO3401A; SOT-23; MPN AO3401A; LCSC C15127
Q2: HJ8205; SOT-23-6; MPN HJ8205; LCSC C20069150
Q3: 2N7002; SOT-23; LCSC C8545
R1, R2: 5.1k; R_0603_1608Metric; LCSC C23186
R3, R12: 1k; R_0603_1608Metric; LCSC C21190
R4: 1.2k; R_0603_1608Metric; LCSC C22765
R5: 10k; R_0603_1608Metric; LCSC C25804
R6, R7, R8, R10: 100k; R_0603_1608Metric; LCSC C25803
R9: 1.5k; R_0603_1608Metric; LCSC C22843
R11: 100; R_0603_1608Metric; LCSC C22775
R13: 1M; R_0603_1608Metric; LCSC C22935
R14, R15: 220k; R_0603_1608Metric; LCSC C22961
SW1: MSK12C02; SW_SPDT_MSK12C02_EdgeNotch; MPN MSK12C02G15-B; LCSC C22435661
U1: SRV05-4; SOT-23-6; MPN SRV05-4-P-T7; LCSC C85364
U2: BQ24073RGT; VQFN-16-1EP_3x3mm_P0.5mm_EP1.6x1.6mm; MPN BQ24073RGTR; LCSC C15220
U3: DW01A; SOT-23-6; MPN DW01A; LCSC C42380662
U4: TPS63031DSK; WSON-10-1EP_2.5x2.5mm_P0.5mm_EP1.2x2mm; MPN TPS63031DSKR; LCSC C15516

Connections:
+3V3: C7.1, C8.1, R8.1, U4.1 (VOUT), U4.10 (FB); also elsewhere on the board
+BATT: C3.1, Q1.2 (S), R11.1, R14.1, U2.2 (BAT), U2.3 (BAT)
/Power/3V3_EN: R13.1, SW1.2 (B), U4.6 (EN)
/Power/BATT_RAW_P: BT1.1 (+), J2.1, Q1.3 (D)
/Power/CC1: J1.A5 (CC1), R1.1, U1.4 (IO3)
/Power/CC2: J1.B5 (CC2), R2.1, U1.6 (IO4)
/Power/CHG_N: D1.1 (K), U2.9 (~CHG)
/Power/DW_CS: R12.1, U3.2 (CS)
/Power/DW_OC: Q2.4 (G2), U3.3 (OC)
/Power/DW_OD: Q2.6 (G1), U3.1 (OD)
/Power/EN1: Q3.3 (D), R6.2, U2.6 (EN1)
/Power/ILIM: R4.1, U2.12 (ILIM)
/Power/ISET: R3.1, U2.16 (ISET)
/Power/SW_L1: L1.1, U4.4 (L1)
/Power/SW_L2: L1.2, U4.2 (L2)
/Power/TS: R5.1, U2.1 (TS)
CHG_HI: Q3.1 (G), R7.1, U2.5 (EN2); also elsewhere on the board
unnamed: D1.2 (A), R9.2
unnamed: Q1.1 (G), R10.1
unnamed: Q2.2 (D), Q2.5 (D)
USB_DM: J1.A7 (D-), J1.B7 (D-), U1.3 (IO2); also elsewhere on the board
USB_DP: J1.A6 (D+), J1.B6 (D+), U1.1 (IO1); also elsewhere on the board
VBAT_SENSE: C9.1, R14.2, R15.1; also elsewhere on the board
VBUS_DET: R8.2, U2.7 (~PGOOD); also elsewhere on the board
VSYS: C2.1, C5.1, C6.1, R9.1, SW1.1 (A), U2.10 (OUT), U2.11 (OUT), U4.5 (VIN), U4.8 (VINA); also elsewhere on the board
