jnd-cz/kids-timer/kids-timer.kicad_pcb

## KiCad design kids-timer.kicad_pcb (continued)

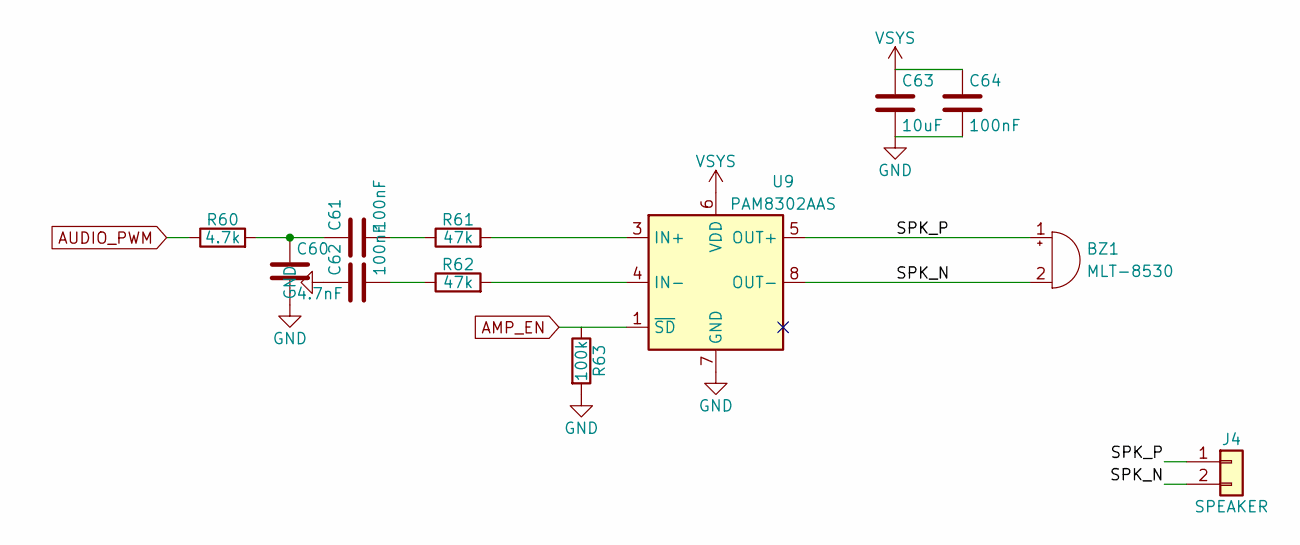
[picture p7: schematic audio.kicad_sch]

Parts:
BZ1: MLT-8530; Buzzer_HNDZ_MLT-8530_8.5x8.5mm; MPN MLT-8530; LCSC C94599
C60: 4.7nF; C_0402_1005Metric; LCSC C1538
C61, C62, C64: 100nF; C_0402_1005Metric; LCSC C1525
C63: 10uF; C_0805_2012Metric; LCSC C15850
J4: SPEAKER; JST_PH_S2B-PH-SM4-TB_1x02-1MP_P2.00mm_Horizontal; MPN S2B-PH-SM4-TB(LF)(SN); LCSC C295747
R60: 4.7k; R_0402_1005Metric; LCSC C25900
R61, R62: 47k; R_0402_1005Metric; LCSC C25792
R63: 100k; R_0402_1005Metric; LCSC C25741
U9: PAM8302AAS; MSOP-8_3x3mm_P0.65mm; MPN PAM8302AASCR; LCSC C113367

Connections:
/Audio/SPK_N: BZ1.2 (-), J4.2, U9.8 (OUT-)
/Audio/SPK_P: BZ1.1 (+), J4.1, U9.5 (OUT+)
AMP_EN: R63.1, U9.1 (~SD); also elsewhere on the board
AUDIO_PWM: R60.1; also elsewhere on the board
unnamed: C60.1, C61.1, R60.2
unnamed: C61.2, R61.1
unnamed: C62.2, R62.1
unnamed: R61.2, U9.3 (IN+)
unnamed: R62.2, U9.4 (IN-)
VSYS: C63.1, C64.1, U9.6 (VDD); also elsewhere on the board

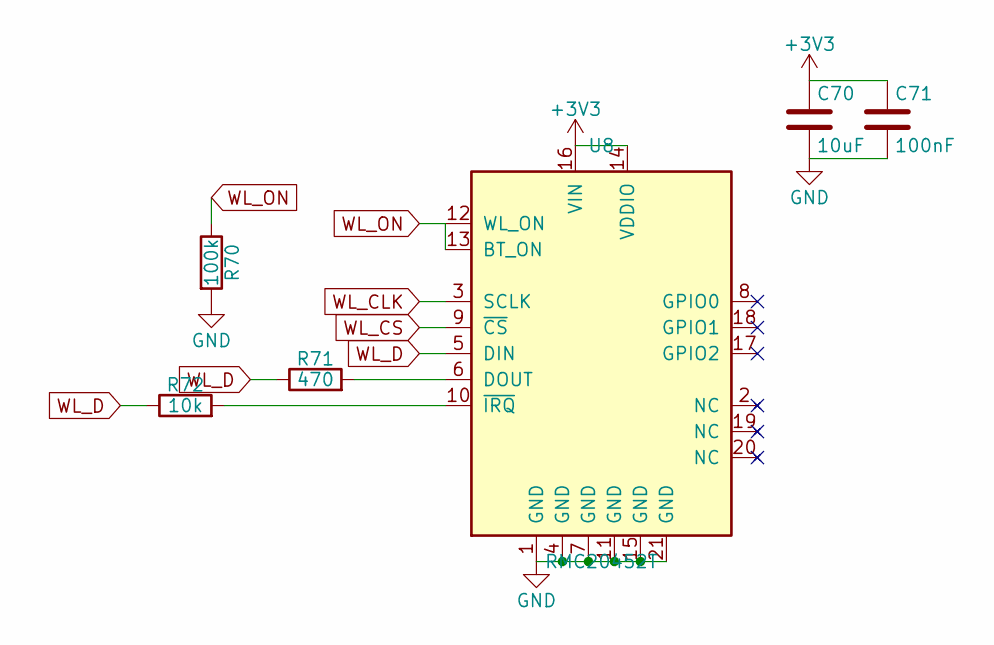
[picture p8: schematic radio.kicad_sch]

Parts:
C70: 10uF; C_0805_2012Metric; LCSC C15850
C71: 100nF; C_0402_1005Metric; LCSC C1525
R70: 100k; R_0402_1005Metric; LCSC C25741
R71: 470; R_0402_1005Metric; LCSC C25117
R72: 10k; R_0402_1005Metric; LCSC C25744
U8: RMC20452T; RaspberryPi_RM2_14.5x16.5mm; MPN RMC20452T; LCSC C49451547

Connections:
+3V3: C70.1, C71.1, U8.14 (VDDIO), U8.16 (VIN); also elsewhere on the board
unnamed: R71.2, U8.6 (DOUT)
unnamed: R72.2, U8.10 (~IRQ)
WL_CLK: U8.3 (SCLK); also elsewhere on the board
WL_CS: U8.9 (~CS); also elsewhere on the board
WL_D: R71.1, R72.1, U8.5 (DIN); also elsewhere on the board
WL_ON: R70.1, U8.12 (WL_ON), U8.13 (BT_ON); also elsewhere on the board

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
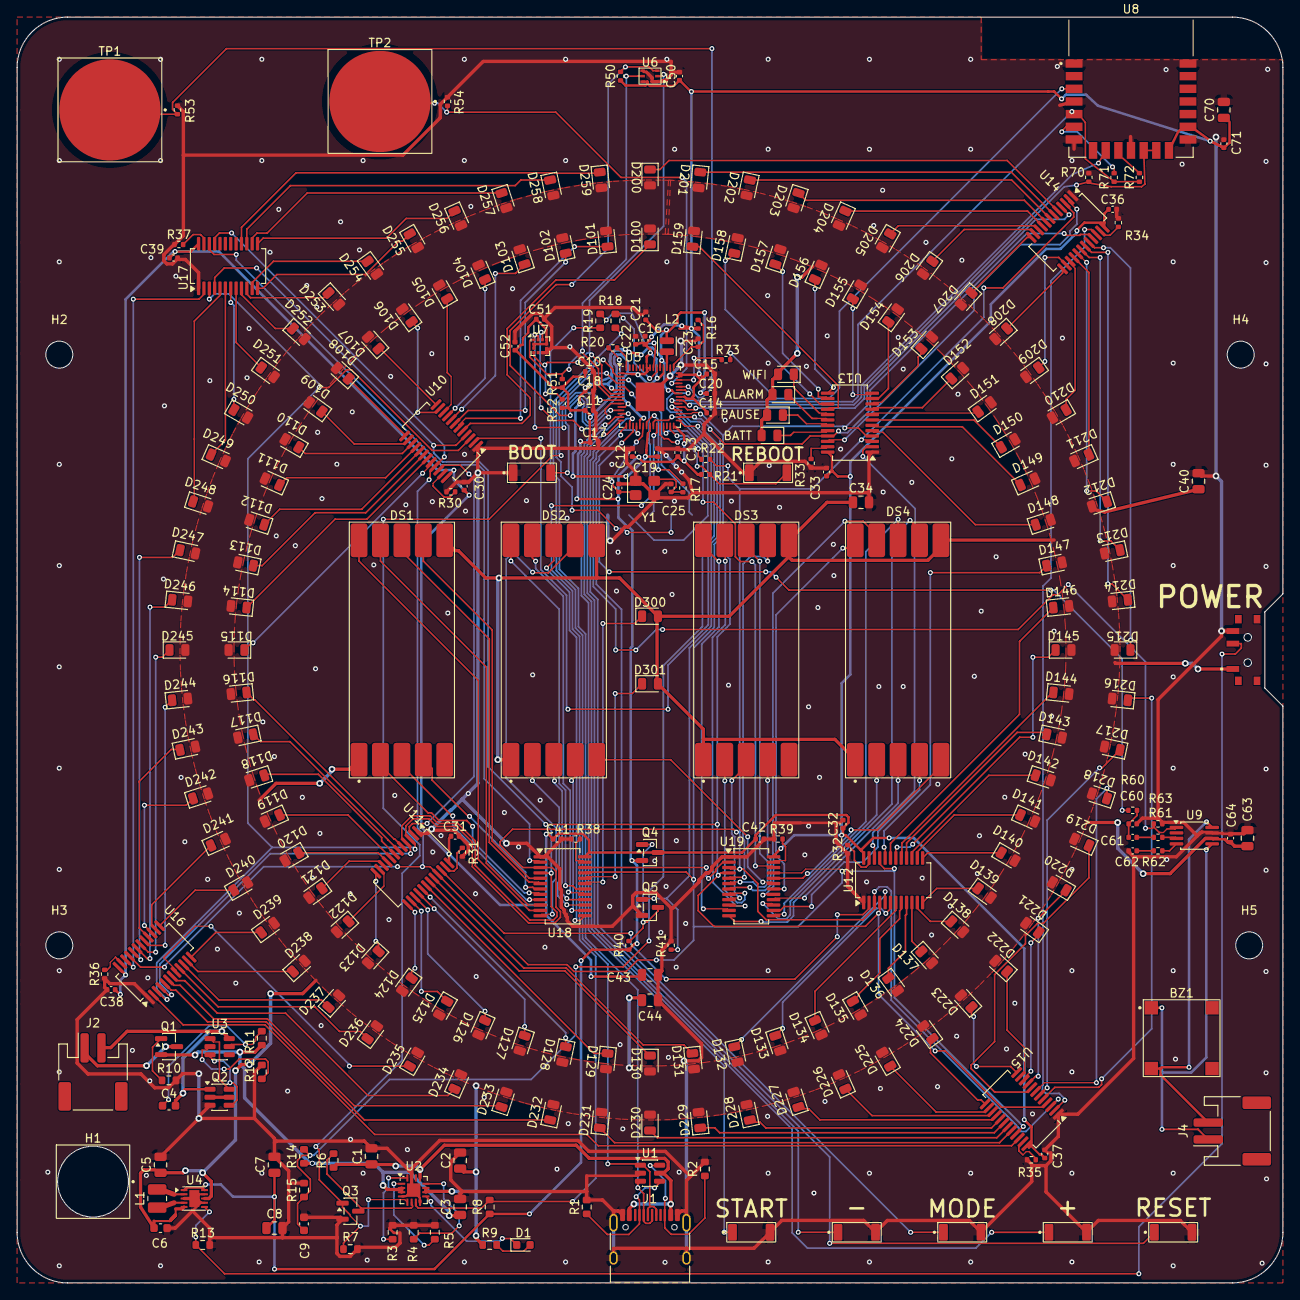
[picture p9: board kids-timer.kicad_pcb from above]

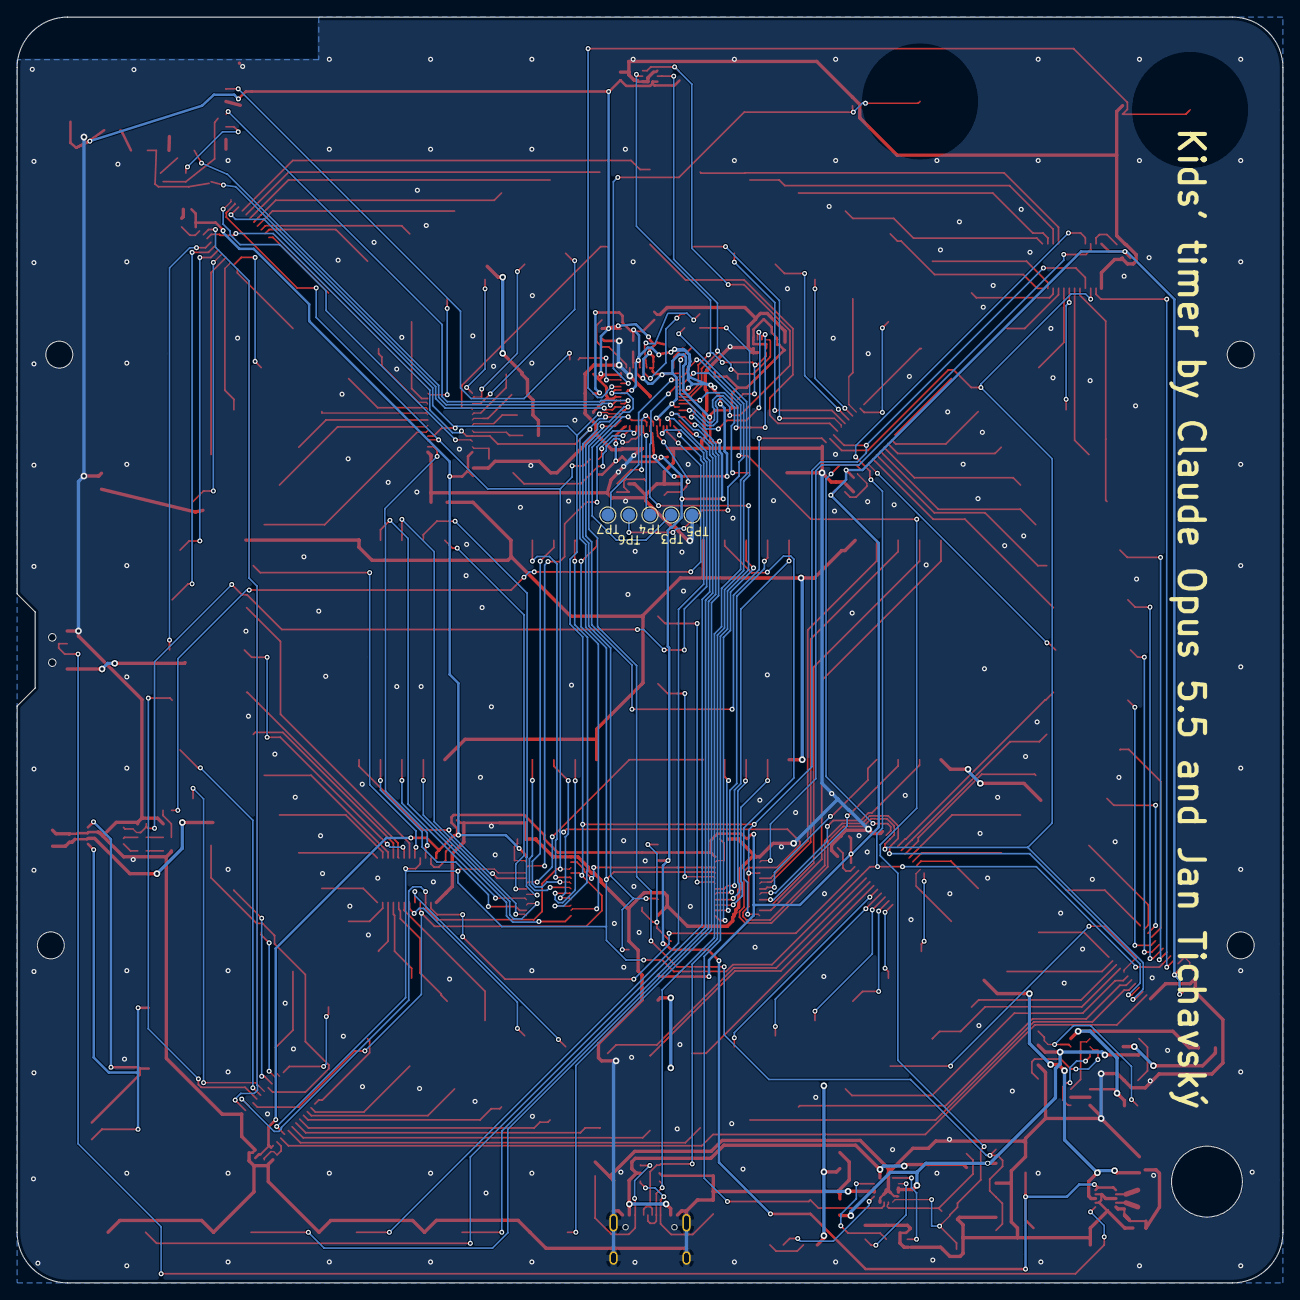
[picture p10: board kids-timer.kicad_pcb from below]

Board: 2 copper layers, 150.0 x 150.0 mm, 278 parts (5 on the bottom side), 256 nets.

Other parts of the board:
H1: WirePassThrough_8.4mm
H2, H3, H4, H5: MountingHole_3.2mm_M3
