jnd-cz/kids-timer/(commit log)

2026-10-16 Initial kids-timer KiCad project: power and MCU sheets
    - Power: USB-C (HRO TYPE-C-31-M-12) with SRV05-4 ESD, BQ24073
    power-path charger, LiPo JST-PH input with optional 18650 holder,
    AO3401A reverse protection, DW01A + HJ8205 cell protection,
    TPS63031 3.3 V buck-boost enabled by side slide switch.
    - MCU: RP2354A with core regulator, 12 MHz crystal, BOOTSEL,
    debug header; GPIOs labelled for LED drivers, sensors, audio, RM2.
    - Project symbol library with HJ8205 dual N-FET.
    [kids-timer.kicad_pcb, kids-timer.kicad_sch, mcu.kicad_sch, power.kicad_sch]
2026-10-16 Add LED driver chain, minute/second rings and 4-digit display
    - 10x SM16206S constant-current drivers in one SPI-style chain
    (MCU -> minutes U10-U13 -> seconds U14-U17 -> display U18-U19 -> MCU),
    shared CLK/LE/OE, drivers powered from switchable 3V3_LED rail
    (AO3401A + 2N7002 load switch, LED_PWR_EN).
    - Minutes ring: 60x green KT-0805G + 4 status LEDs, 3.3k R-EXT (5 mA).
    - Seconds ring: 60x red NCD0805R1, 3.3k R-EXT (5 mA).
    - Display: 4x GS8011AW-G 0.8in white digits, white colon LEDs,
    DP on digits 2 and 4, 2k R-EXT (8.25 mA). LED anodes on VSYS.
    - Project library: SM16206S and GS8011AW symbols, GS8011 SMD footprint.
    [display.kicad_sch, kids-timer.kicad_sch, minutes.kicad_sch, seconds.kicad_sch]
2026-10-16 Add reset button, LED_CLK series resistor, yellow status LEDs
    - SW3 reset button on RUN.
    - R22 33R source termination on the shared LED_CLK line (10 loads).
    - Status LEDs D160-D163 changed to yellow KT-0805Y (0805, basic).
    [mcu.kicad_sch, minutes.kicad_sch]
2026-10-16 Add sensors/UI, audio and RM2 radio sheets
    - Sensors & UI: VEML6030 light sensor (I2C 0x10, INT), SC7A20H
    accelerometer (I2C 0x19, INT1/INT2), 4.7k I2C pull-ups, 3 user
    buttons (TS-1187A), 2 capacitive touch pads with 1M bleeders.
    - Audio: PAM8302A class-D amp from filtered PWM (4.7k/4.7nF, 47k input
    resistors), AMP_EN shutdown control, MLT-8530 buzzer and JST-PH
    speaker connector on the bridge output.
    - Radio: RM2 (RMC20452T) in Pico 2 W pin mapping (GP23/24/25/29),
    470R DOUT and 10k IRQ onto WL_D, 100k pull-down on WL_ON.
    - New symbols (VEML6030, SC7A20H, RM2) and footprints (VEML6030,
    RM2, MLT-8530, touch pad); BOOT/RESET buttons set to TS-1187A.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
    [audio.kicad_sch, kids-timer.kicad_sch, mcu.kicad_sch, radio.kicad_sch, sensors.kicad_sch]
2026-10-16 Make BOM Economic-PCBA eligible; fill missing LCSC parts
    - U7: SC7A20H (Standard-only LGA) -> STK8328-C C49230199, I2C addr 0x1F
    - L2: AOTA-B201610S3R3 (out of stock) -> YSMC201612H-3R3MB C41405891
    - SW2-SW6: TS-1187A -> Basic TS-1088-AR02016 C720477, new footprint
    - J2/J4: JST S2B-PH-SM4-TB right-angle C295747
    - U8: RM2 is stocked at JLC as C49451547
    [audio.kicad_sch, mcu.kicad_sch, power.kicad_sch, radio.kicad_sch, sensors.kicad_sch]
2026-10-16 Swap crystal to Basic YXC X322512MSB4SI with 33pF load caps
    Y1 ABM8-272-T3 (CL 10pF, ext) -> X322512MSB4SI C9002 (CL 20pF, basic).
    C24/C25 15pF -> 33pF C0G C1562: 2*(20pF - 2.5pF stray) = 35pF,
    stray taken from the Pico 2 reference (10pF crystal with 15pF caps).
    R17 1k kept; estimated drive ~70uW vs 200uW max.
    [mcu.kicad_sch]
2026-10-16 PCB: 150mm outline and initial placement of all parts
    - Rings: green minutes r=49mm, red seconds r=56mm, anodes face a shared
    VSYS gap; rotatable LED_0805_2012Metric_Ring footprint for the rings
    - Display centred, MCU block above, display drivers + load switch below
    - Minute drivers inside the rings, second drivers in the side strips
    - Bottom: power/charger left, USB-C centre, buttons + audio right
    - RM2 top-right with antenna at the top edge, 8.4mm battery lead hole
    - JLC design rules: 0.15mm track/clearance, 0.3/0.6mm vias
    [kids-timer.kicad_pcb, minutes.kicad_sch, seconds.kicad_sch]
2026-10-16 Add BTN4/BTN5, switch finger notch, SWD/UART test pads; drop J3
    - SW7/SW8 (TS-1088) on GP9/GP13; five user buttons in an 11mm-pitch
    row along the bottom-right edge, R2 moved up to make room
    - SW1 uses kids-timer:SW_SPDT_MSK12C02_EdgeNotch, which carries the
    right board edge with a 45-degree notch; knob tip ~1.1mm inside edge
    - Debug header J3 removed; SWCLK/SWDIO/GND + UART TX/RX as 1.5mm test
    pads on the back (TP3-TP7)
    - Default netclass clearance 0.15mm (for the U7 LGA)
    [kids-timer.kicad_pcb, mcu.kicad_sch, power.kicad_sch, sensors.kicad_sch]
2026-10-16 Move audio cluster up into the corner pocket, widen button pitch
    - PAM8302 + input RC/decoupling, buzzer and speaker JST moved up out of
    the button strip
    - BTN1-5 at 12.5mm pitch with a clear zone around each button
    [kids-timer.kicad_pcb]
2026-10-16 Add 33R series resistor R73 on WL_CLK at the MCU
    Source termination for the ~70mm SPI clock run to the RM2 module,
    placed next to RP2354 pin 43 (GPIO29) like R22 on LED_CLK.
    [kids-timer.kicad_pcb, mcu.kicad_sch]
2026-10-16 Add VSYS copper ring between the LED rings
    F.Cu annulus r=49.3-55.7mm (thermal reliefs) feeding all 120 ring LED
    anodes; crossing signals go on B.Cu underneath.
    [kids-timer.kicad_pcb]
2026-10-16 Add Power (0.4mm) and Supply (0.3mm) netclasses
    Power: VBUS, VSYS, +BATT, GND, battery-protection and buck-boost switch
    nets. Supply: +3V3, 3V3_LED, +1V1, VREG_LX, speaker outputs.
2026-10-19 PCB: Freerouting autoroute (raw), 10 unrouted, ring breaks to fix
    [kids-timer.kicad_pcb]
2026-10-19 Repair VSYS ring after autoroute
    - 21 short B.Cu bridges (0.3mm, 0.6/0.3 vias) re-join the 22 ring
    islands created by F.Cu tracks crossing the band
    - 0.4mm F.Cu feed from the display common anodes (DS4.6) into the ring
    joins the display/colon/status VSYS group to the main supply
    - VSYS_RING pad connection solid (no starved thermals)
    [kids-timer.kicad_pcb]
2026-10-19 Re-place LED drivers for planar fan-out, open up MCU surroundings
    - Inner (minute) ring LEDs renumbered counter-clockwise; minute drivers
    rotated at the inner diagonals so OUT0..15 fan to their 90-degree arc
    without crossings (was 16-38 crossings per driver)
    - Second drivers moved to the outer diagonals (r=70mm), rotated to face
    their arcs; Rext/VDD caps at each driver's control end
    - Status LEDs D160-163 next to U13 OUT12-15; audio amp block moved to
    the right strip
    - MCU decoupling caps moved ~2.5mm out and turned radial to leave
    escape channels; crystal group moved down
    - Cmts.User annulus outline (r 49.05-55.95) to convert into an F.Cu
    track/via keep-out over the VSYS ring be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
    [kids-timer.kicad_pcb]
2026-10-20 Route board with drivers snapped to 45 degrees
    LED drivers at odd angles gave Freerouting 160 permanent pad violations
    and an 83 % fan-out; at multiples of 45 it routes in 30 passes.
    Imported freerouting-45.ses, fed C40 into VSYS, rerouted XIN short,
    connected +1V1 pin 23 and widened a 0.12 mm AMP_EN neck.
    Open: ACC_INT2, two dangling XIN vias.
    [kids-timer.kicad_pcb]
2026-10-20 Complete routing: hand-routed ACC_INT2, closed VSYS ring
    User routed ACC_INT2, straightened several traces and made the VSYS
    ring a full circle. DRC: 0 errors, 0 unconnected. ERC clean.
    [kids-timer.kicad_pcb, mcu.kicad_sch, sensors.kicad_sch]
2026-10-20 RM2 flush at board edge, antenna keep-out, GND pours with stitching
    Fix RM2 footprint body/courtyard to the datasheet (module top 5.0 mm
    above pin 1), move U8 down 2.65 mm so the module is flush with the top
    edge, reroute its connections. GND pours on F.Cu and B.Cu with the
    35.5 x 5 mm antenna keep-out cut out, 96 stitching vias.
    Open: nine orphan vias near U8 to delete in KiCad.
    [kids-timer.kicad_pcb]
2026-10-20 Add 124 GND stitching vias to recover inner pour islands
    [kids-timer.kicad_pcb]
2026-10-20 Tighten regulator layouts: L1 beside U4 switch pins, L2 above RP2354 VREG_LX
    [kids-timer.kicad_pcb]
2026-10-20 Remove orphan vias after regulator rework; DRC clean
    [kids-timer.kicad_pcb]
2026-10-20 Rename user buttons and status LEDs to their functions
    START, -, MODE, +, RESET buttons; BOOT, REBOOT, POWER; WIFI, ALARM,
    PAUSE, BATT LEDs. Global labels pin the five auto-named nets so routed
    copper is unchanged.
    [kids-timer.kicad_pcb, mcu.kicad_sch, minutes.kicad_sch, power.kicad_sch, sensors.kicad_sch]
2026-10-20 Give every power symbol a unique designator so KiCad's Update PCB (F8) works
    [audio.kicad_sch, display.kicad_sch, mcu.kicad_sch, minutes.kicad_sch, radio.kicad_sch, seconds.kicad_sch, sensors.kicad_sch]
2026-10-20 Copy LCSC and other symbol fields to footprints (KiCad F8)
    [kids-timer.kicad_pcb]
2026-10-20 KiCad annotation: function designators get numeric suffix (START1, +1, ...)
    [audio.kicad_sch, display.kicad_sch, kids-timer.kicad_sch, mcu.kicad_sch, minutes.kicad_sch, power.kicad_sch, radio.kicad_sch, seconds.kicad_sch]
2026-10-21 Revert function designators to SW1-SW8, D160-D163; add Label field with the function name
    [mcu.kicad_sch, minutes.kicad_sch, power.kicad_sch, sensors.kicad_sch]
2026-10-21 Board: designators back to SW1-SW8/D160-D163, function names as silkscreen text
    [kids-timer.kicad_pcb]
2026-10-21 Show function names via each footprint's Label field on silkscreen; designators hidden; drop free texts
    [kids-timer.kicad_pcb]
2026-10-21 Add M3 cover holes H2-H5, pour keep-outs under touch pads, masked touch pads
    - H2-H5: NPTH 3.2 mm at (30,65), (30,135), (170,65), (171,135)
    - TP1/TP2: rule areas (no zone fill, F.Cu + B.Cu, r = 7 mm) so the
    GND pours stay 1 mm clear on top and off the back of the pads
    - Removed the GND stitching vias at (30,66) and (64.12,29.55)
    - Touch pads mask-covered and paste-free (user edit)
    [kids-timer.kicad_pcb]
2026-10-21 Exclude TP1-TP7 and H1-H5 from BOM and position files
    [kids-timer.kicad_pcb]
2026-10-21 Add FT Rotation Offset fields for JLC placement
    Offsets relative to Fabrication Toolkit's own correction table, taken
    from the rotations made in JLC's preview: J2, J4, SW1, U6 +180;
    U3 +90; U5, U7 and LED drivers U10-U19 -90.
    [kids-timer.kicad_pcb]
2026-10-30 Rev 1 as ordered: back-silk credit, JLC production files, bring-up notes
    - Back silkscreen credit text
    - production/: Gerbers, BOM, CPL and IPC netlist exactly as sent to JLCPCB
    - BRINGUP.md: power-up sequence, flash-size check, GPIO map, LED chain
    map, battery and firmware notes
    [bom.csv, designators.csv, kids-timer.kicad_pcb, positions.csv]
2026-10-30 Add MicroPython timer firmware and hardware tests
